keshavshankar08/DickerBot/images/CommunicatorPCB.jpeg

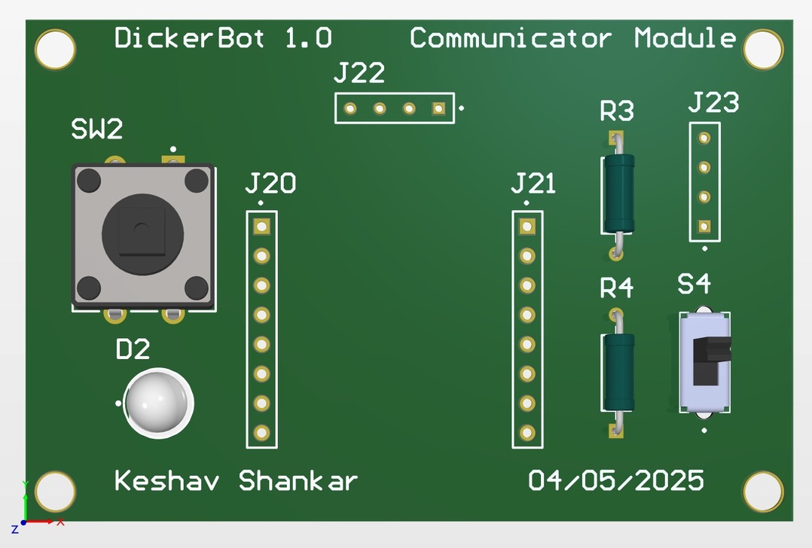
images/CommunicatorPCB.jpeg
