keshavshankar08/DickerBot/images/CommunicatorSchematic.jpeg

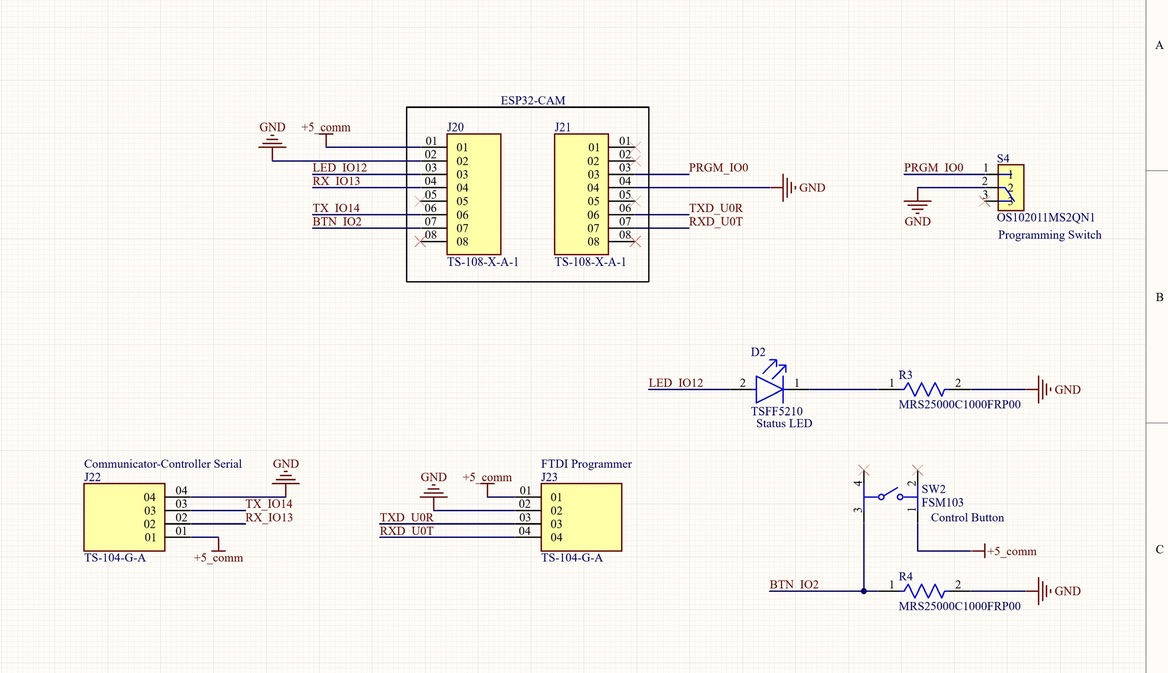
images/CommunicatorSchematic.jpeg
