keshavshankar08/DickerBot/images/ControllerPCB.jpeg

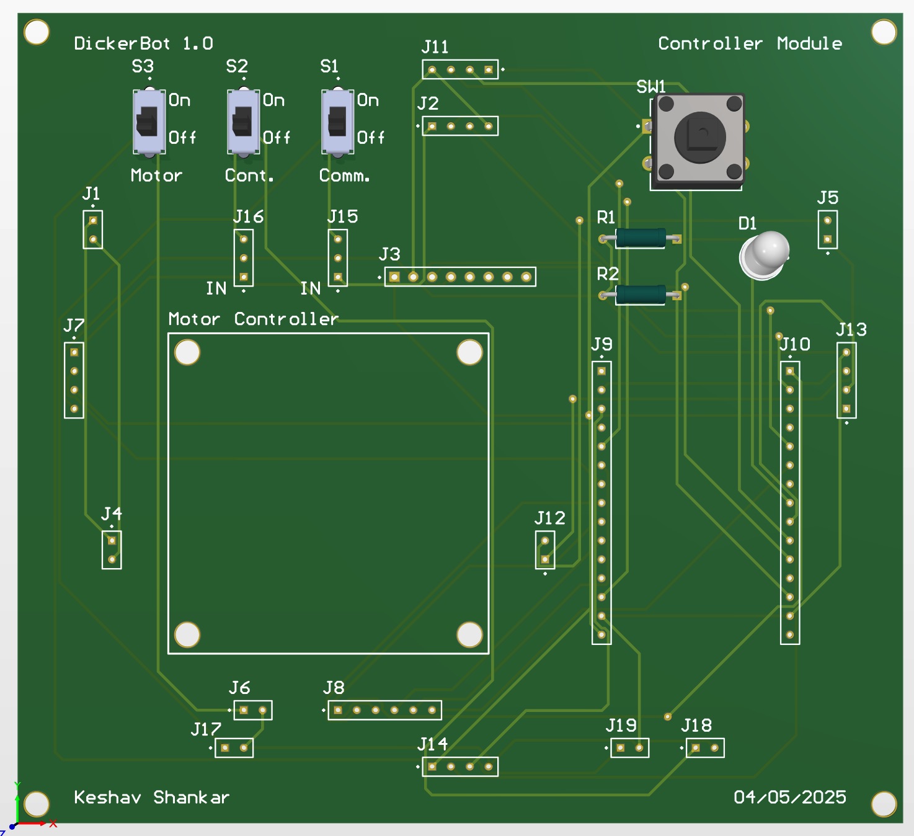
images/ControllerPCB.jpeg
