keshavshankar08/DickerBot/images/ControllerSchematic.jpeg

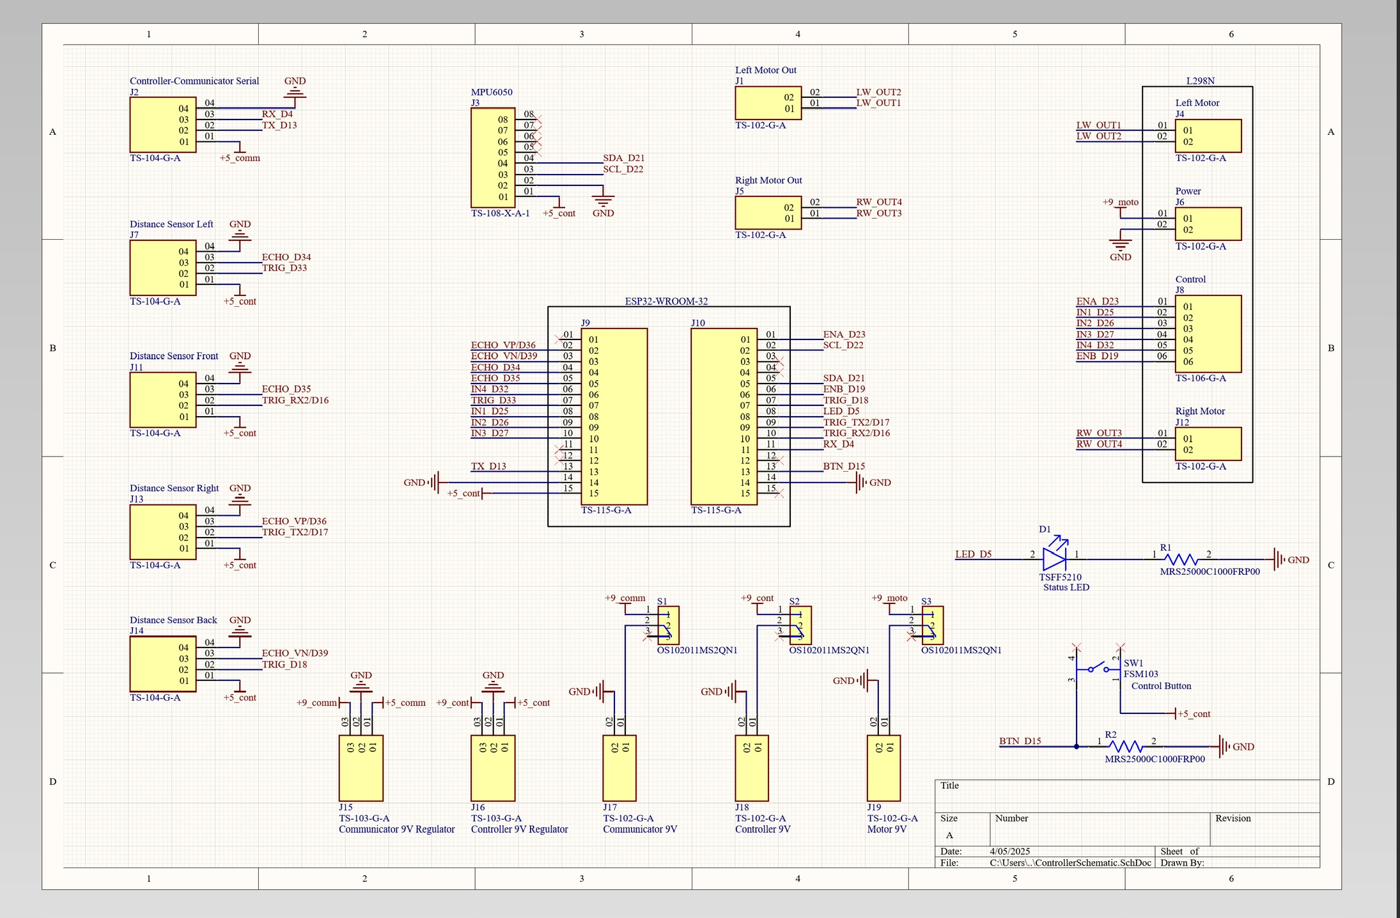
images/ControllerSchematic.jpeg
