keshavshankar08/DickerBot/images/DickerBotBack.jpg

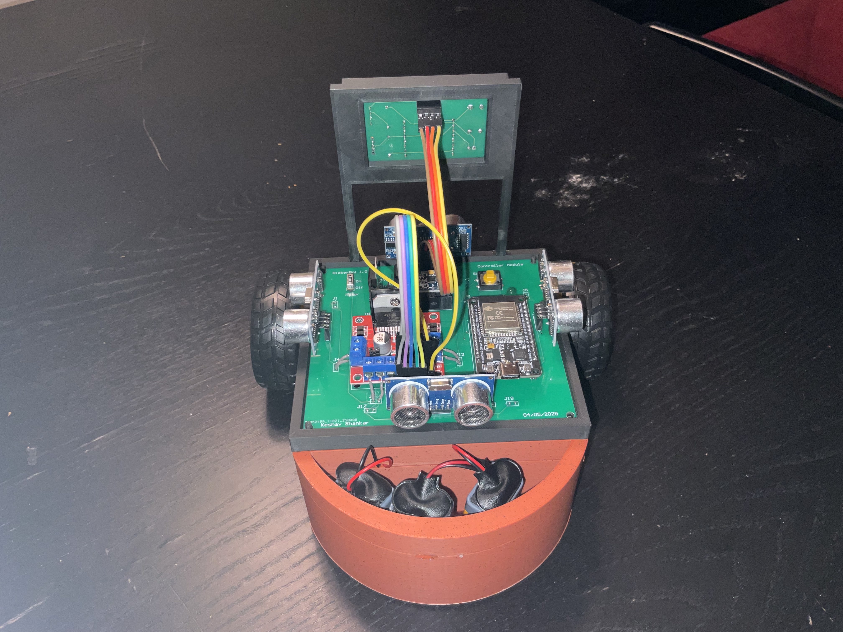
images/DickerBotBack.jpg
