keshavshankar08/DickerBot/images/DickerBotBottom.jpg

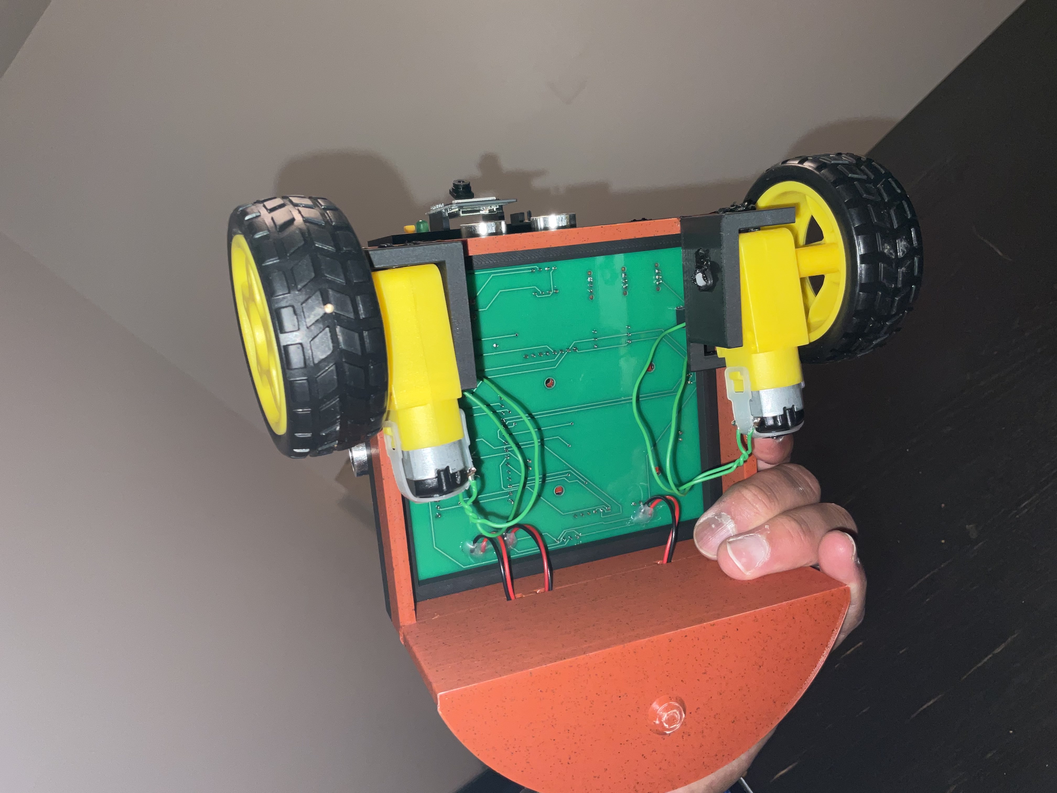
images/DickerBotBottom.jpg
