keshavshankar08/DickerBot/images/DickerBotHost.png

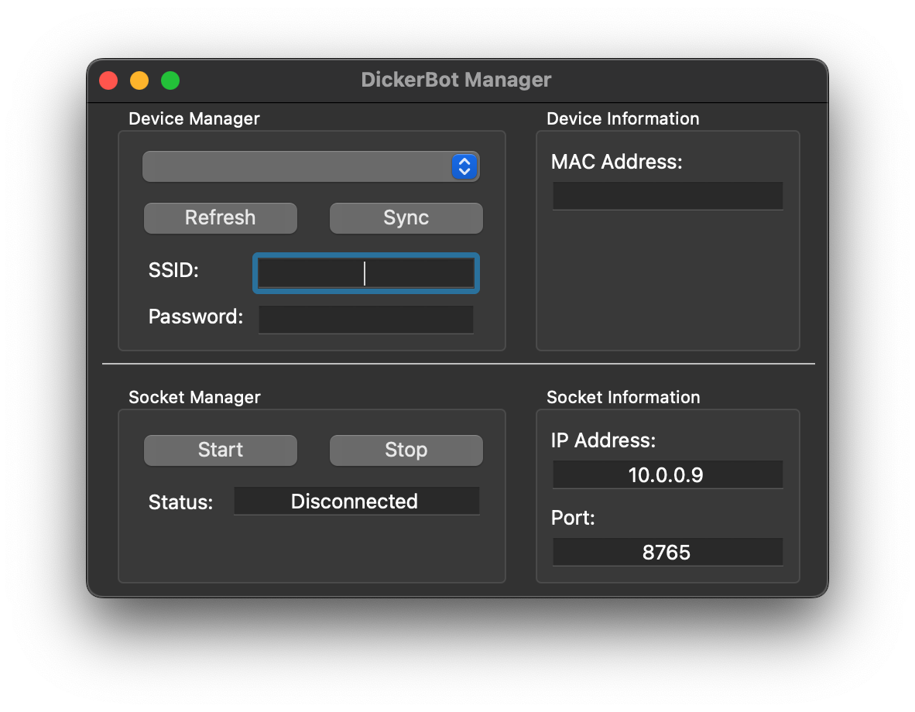
images/DickerBotHost.png
