keshavshankar08/DickerBot/images/DickerBotLeft.jpg

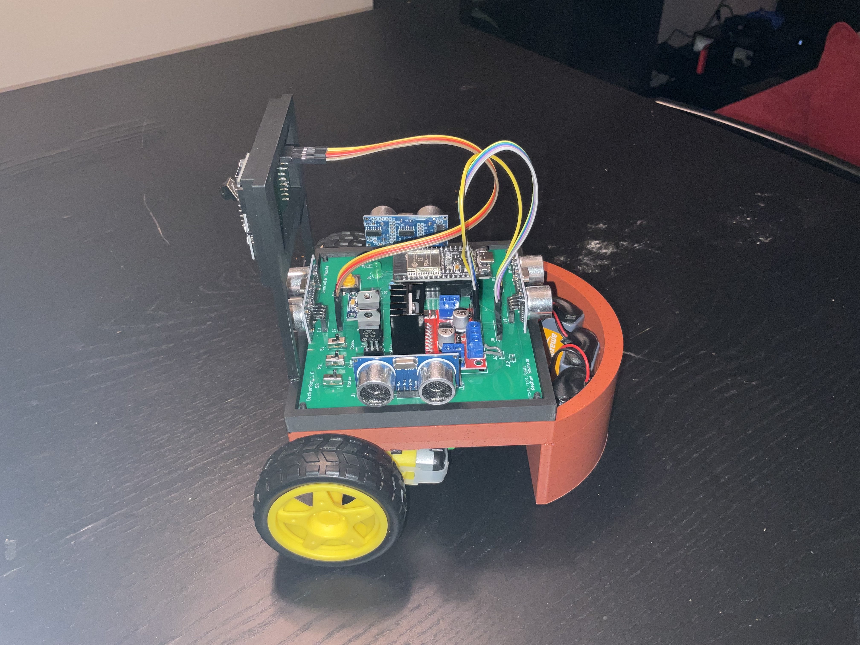
images/DickerBotLeft.jpg
