keshavshankar08/DickerBot/images/DickerBotRight.jpg

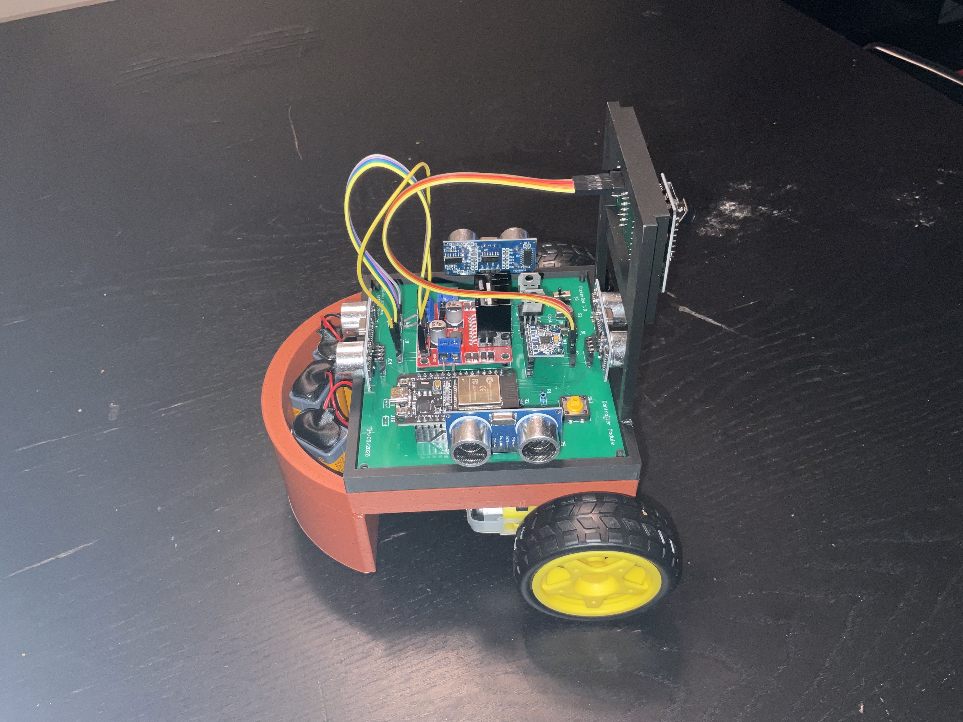
images/DickerBotRight.jpg
