keshavshankar08/DickerBot/(commit log)

2025-04-11 arduino libraries ready for publish
2025-04-11 zip files for DickerBot arduino packages
2025-04-27 update for simulatenous unified wheel control
2025-04-28 added pcb images
